deskwizard/DummyLoadV2/hardware/DummyLoadV2/Output/DummyLoadV2-analog.png

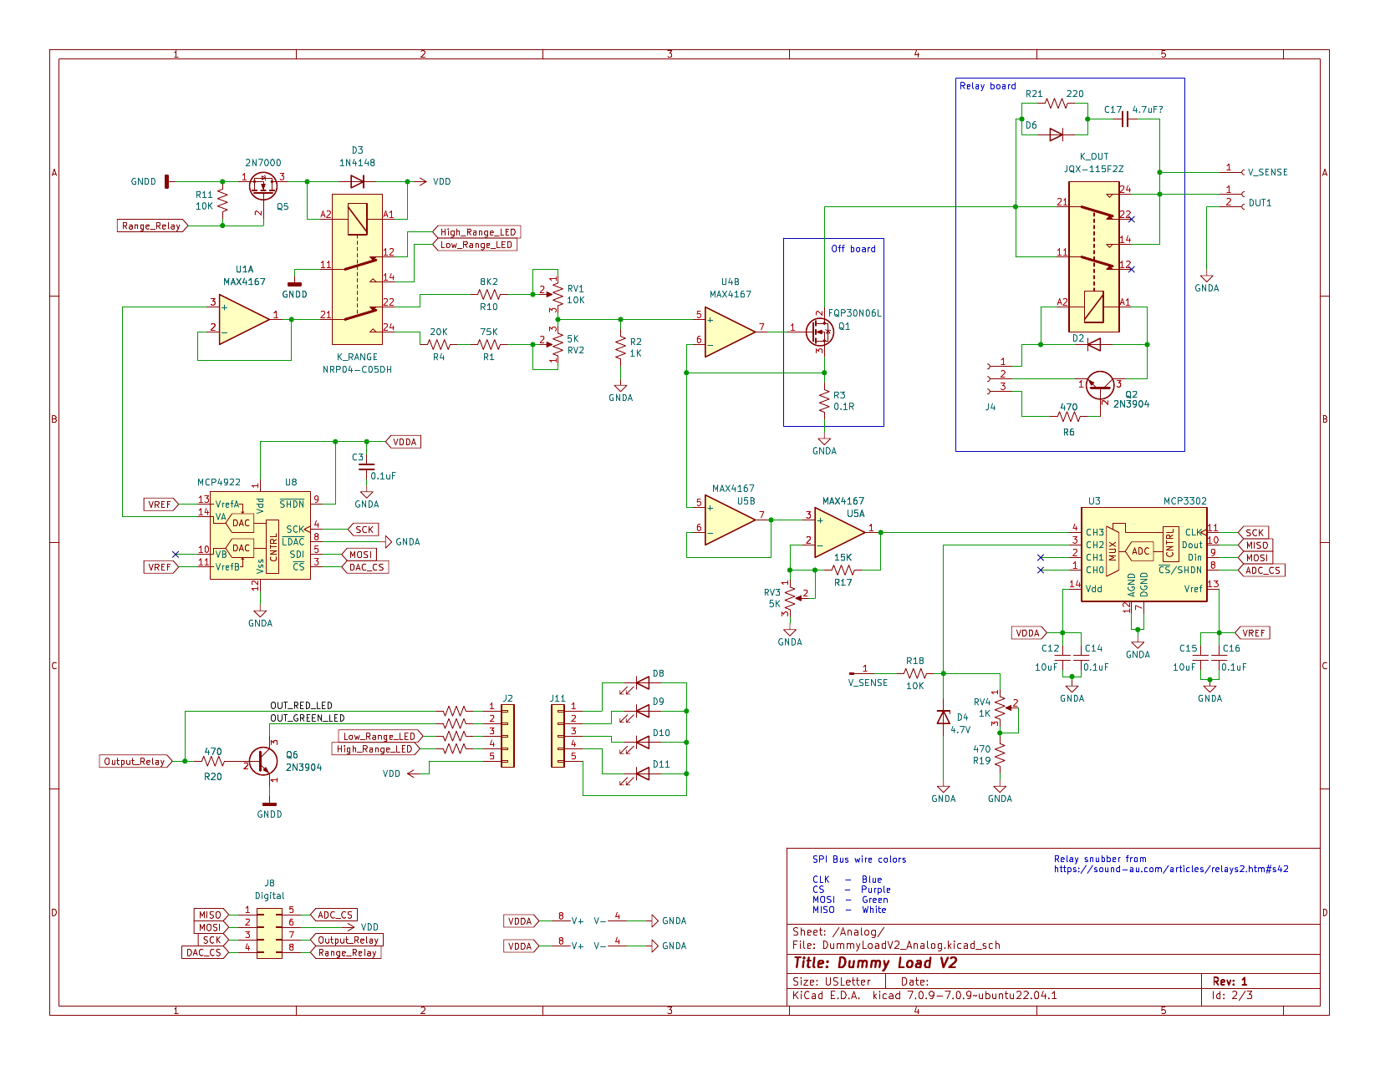
hardware/DummyLoadV2/Output/DummyLoadV2-analog.png
