deskwizard/DummyLoadV2/hardware/DummyLoadV2/Output/DummyLoadV2-digital.png

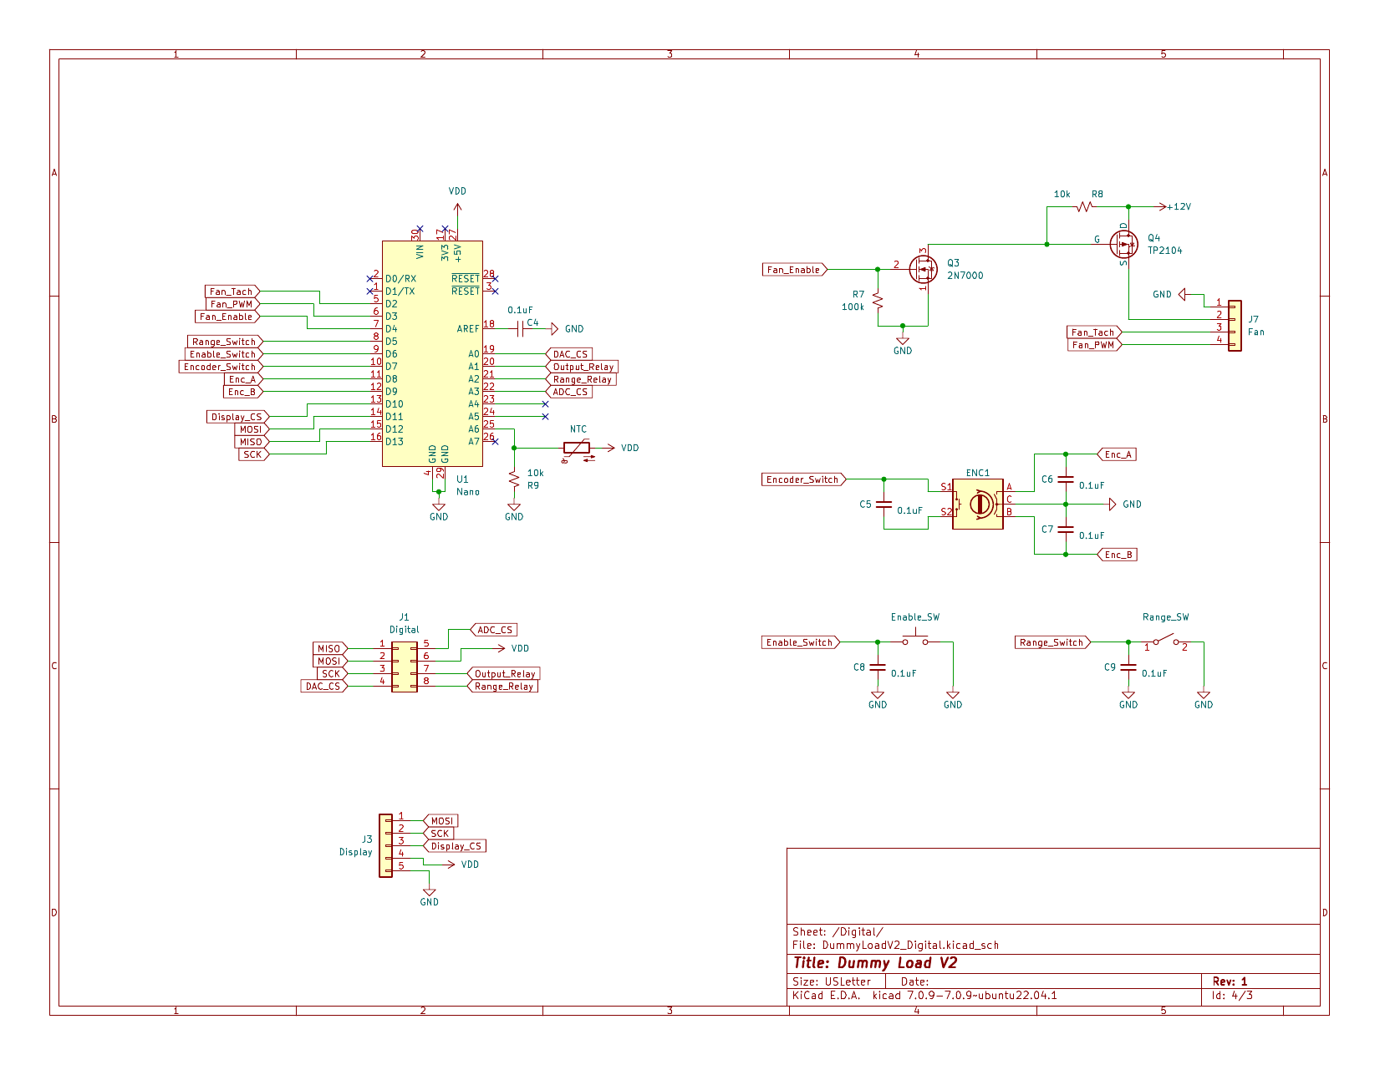
hardware/DummyLoadV2/Output/DummyLoadV2-digital.png
