deskwizard/DummyLoadV2/hardware/DummyLoadV2/Output/DummyLoadV2-main.png

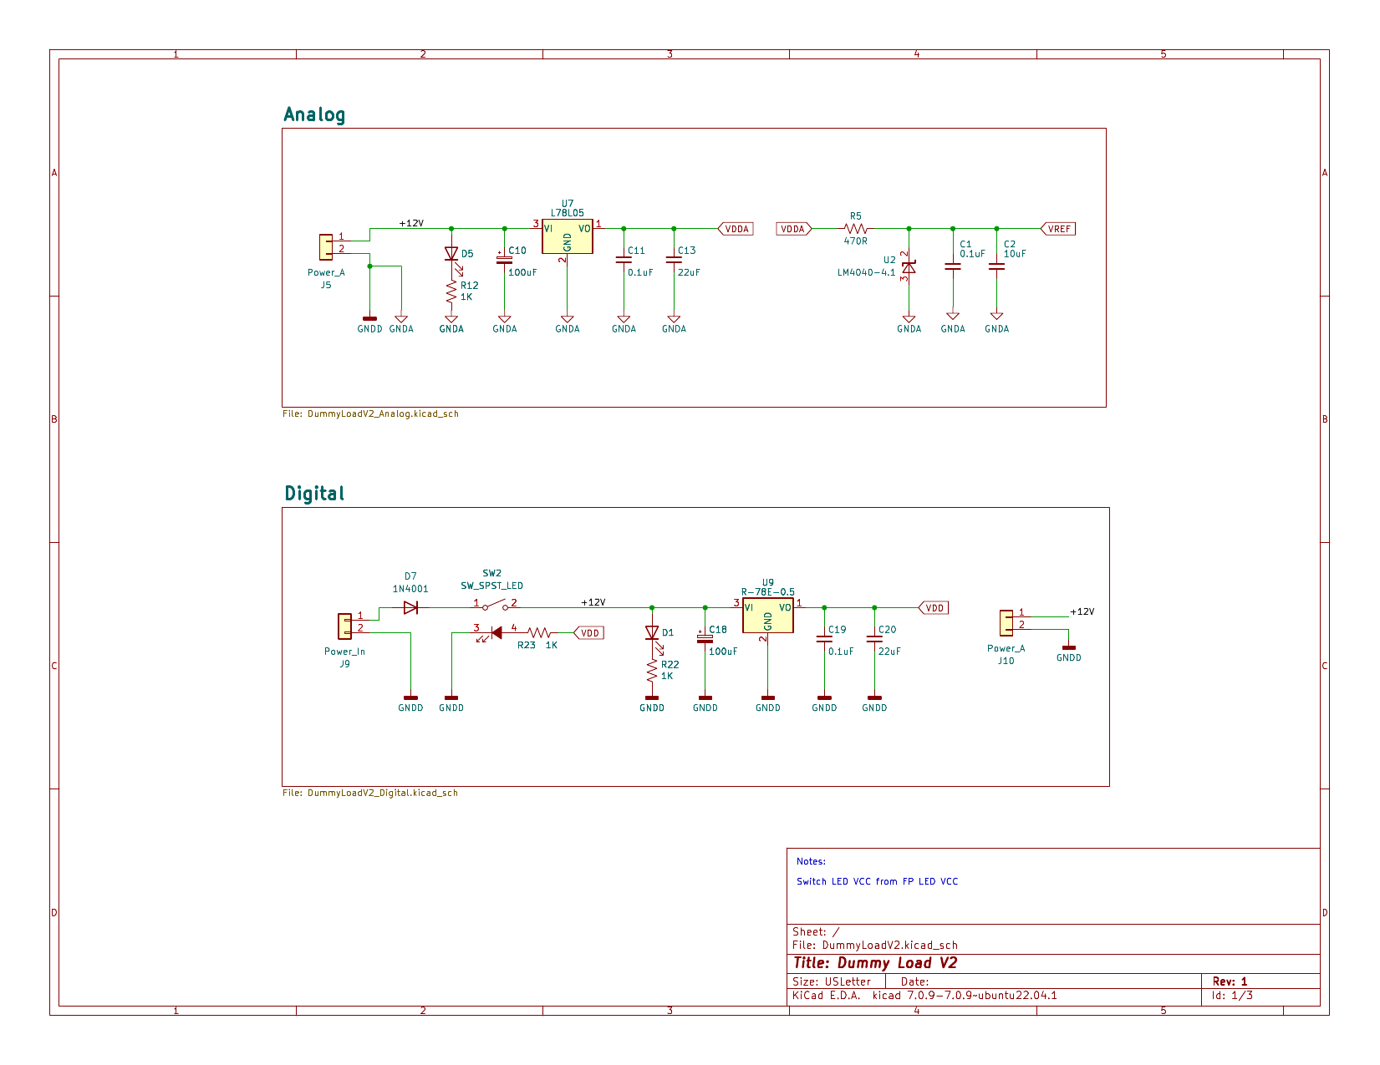
hardware/DummyLoadV2/Output/DummyLoadV2-main.png
