deskwizard/DummyLoadV2/hardware/DummyLoadV2/Output/DummyLoadV2.pdf

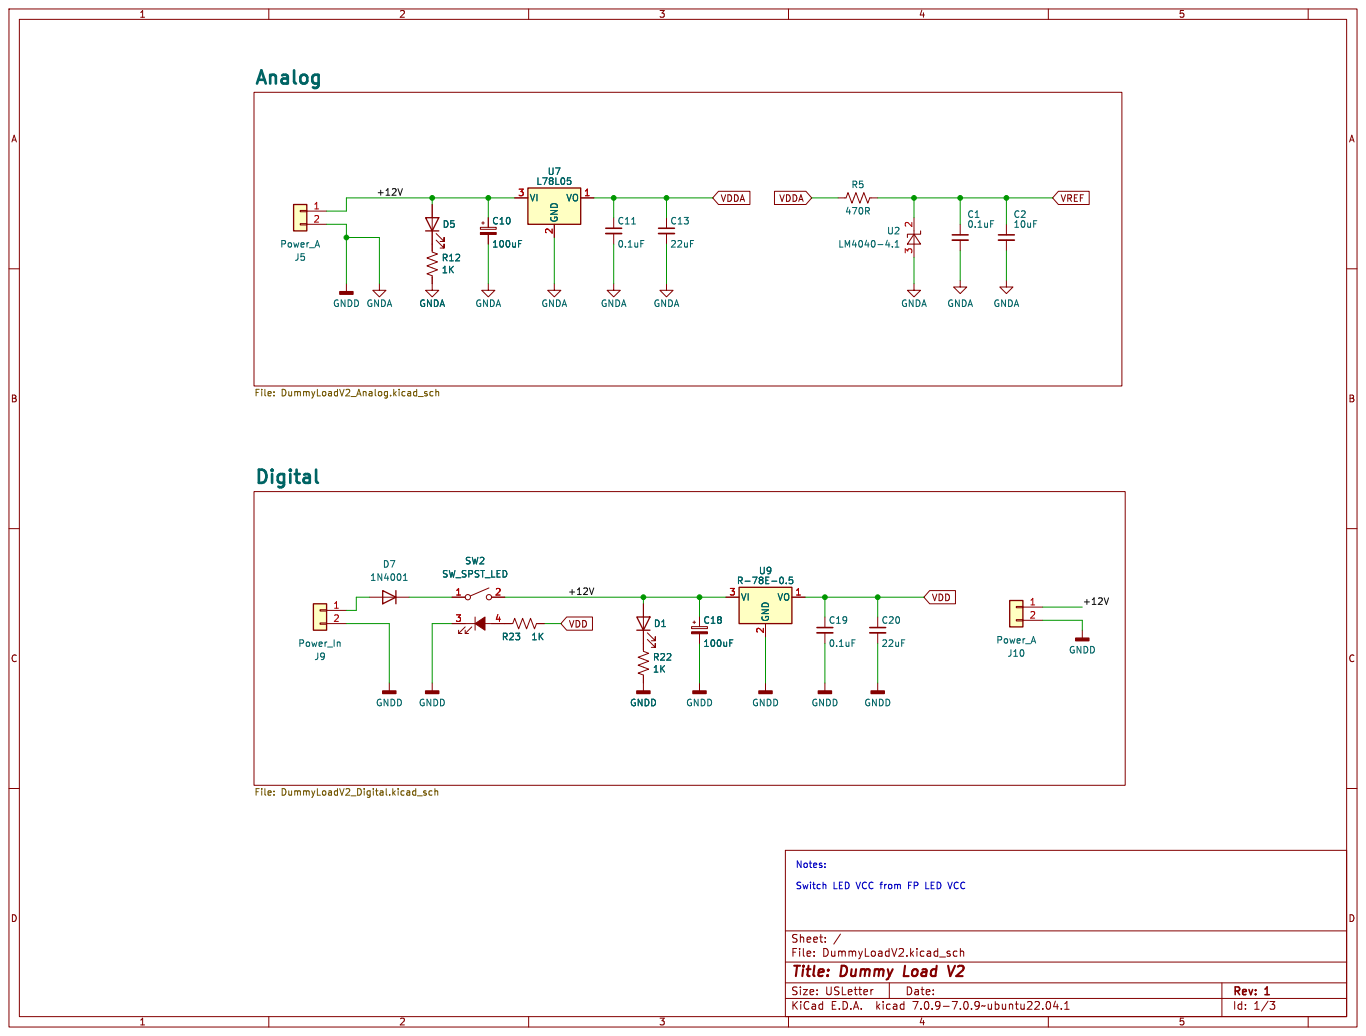
[picture p4: page 1]

+12V Notes: Switch LED VCC from FP LED VCC

Id: 1/3 Title: Dummy Load V2

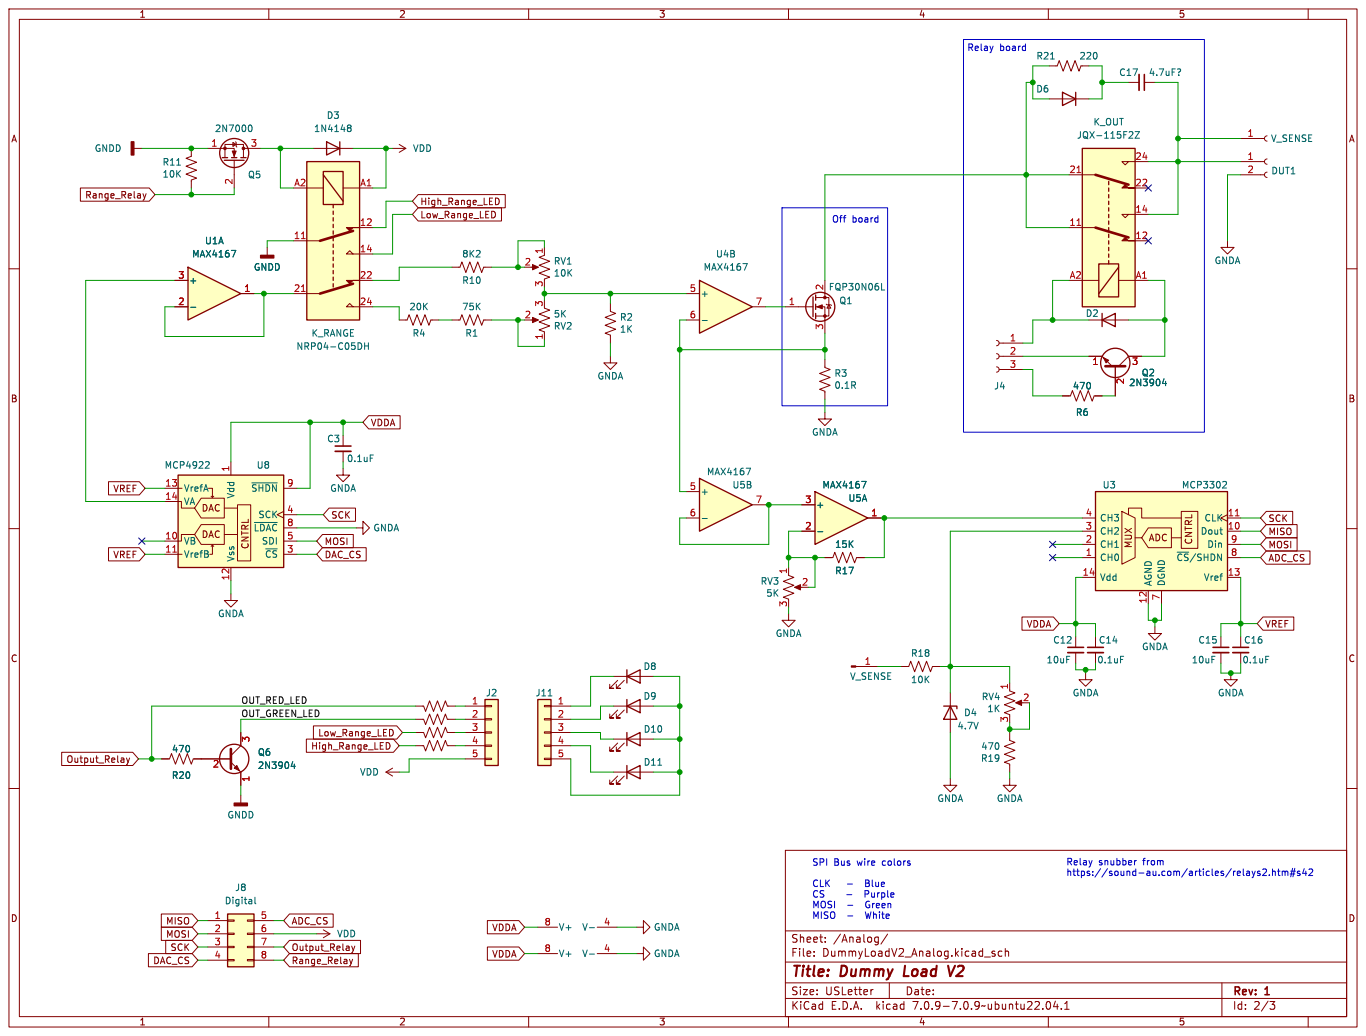
[picture p5: page 2]

1 VB 10 VrefB 11 Vss 12 VrefA 13 VA 14 ~{CS}3 SCK 4 SDI 5 ~{LDAC}8 ~{SHDN}9 MCP4922 U8 R21 220 D6

7 ~{CS}/SHDN 8 Din 9 U3 MCP3302 GNDA

Id: 2/3 Title: Dummy Load V2

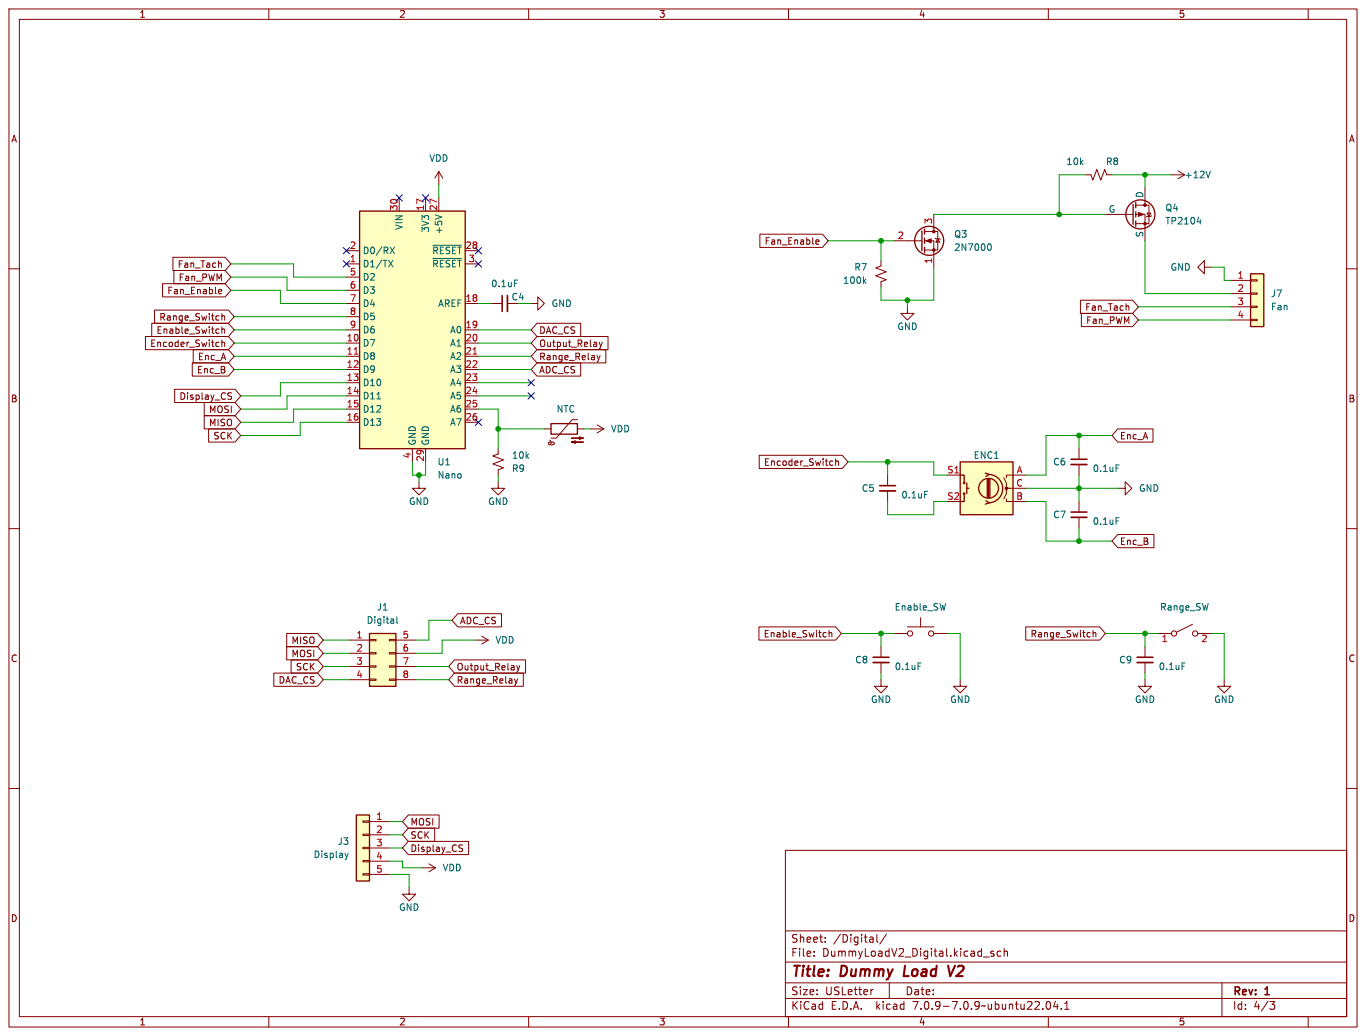
[picture p6: page 3]

File: DummyLoadV2_Digital.kicad_sch Sheet: /Digital/ GND

Id: 4/3 Title: Dummy Load V2
