deskwizard/DummyLoadV2/hardware/DummyLoadV2/DummyLoadV2.kicad_sch

## KiCad design hardware/DummyLoadV2/DummyLoadV2.kicad_sch (2023-11-14, an earlier design)

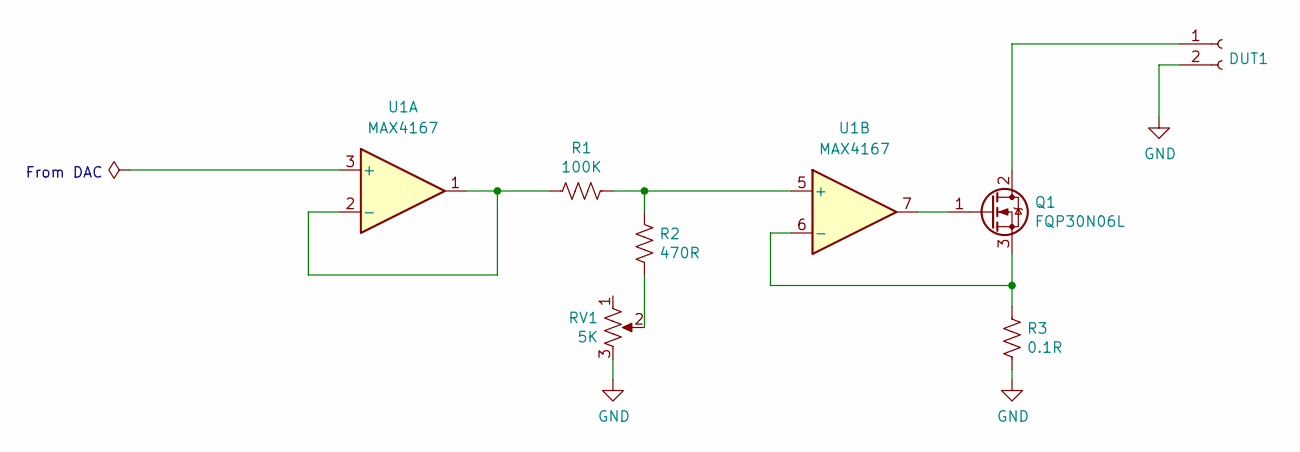
[picture p7: schematic DummyLoadV2.kicad_sch]

Parts:
DUT1: Conn_01x02_Female
Q1: FQP30N06L; TO-252-2
R1: 100K
R2: 470R
R3: 0.1R
RV1: 5K
U1: MAX4167

Connections:
GND: DUT1.2, R3.1, RV1.3
unnamed: DUT1.1, Q1.2 (D)
unnamed: Q1.1 (G), U1.7
unnamed: Q1.3 (S), R3.2, U1.6 (-)
unnamed: R1.1, R2.2, U1.5 (+)
unnamed: R1.2, U1.1, U1.2 (-)
unnamed: R2.1, RV1.2

Notes on the sheet:
From DAC
