deskwizard/DummyLoadV2/hardware/DummyLoadV2/DummyLoadV2_Analog.kicad_sch

## KiCad design hardware/DummyLoadV2/DummyLoadV2_Analog.kicad_sch (2023-11-14, an earlier design)

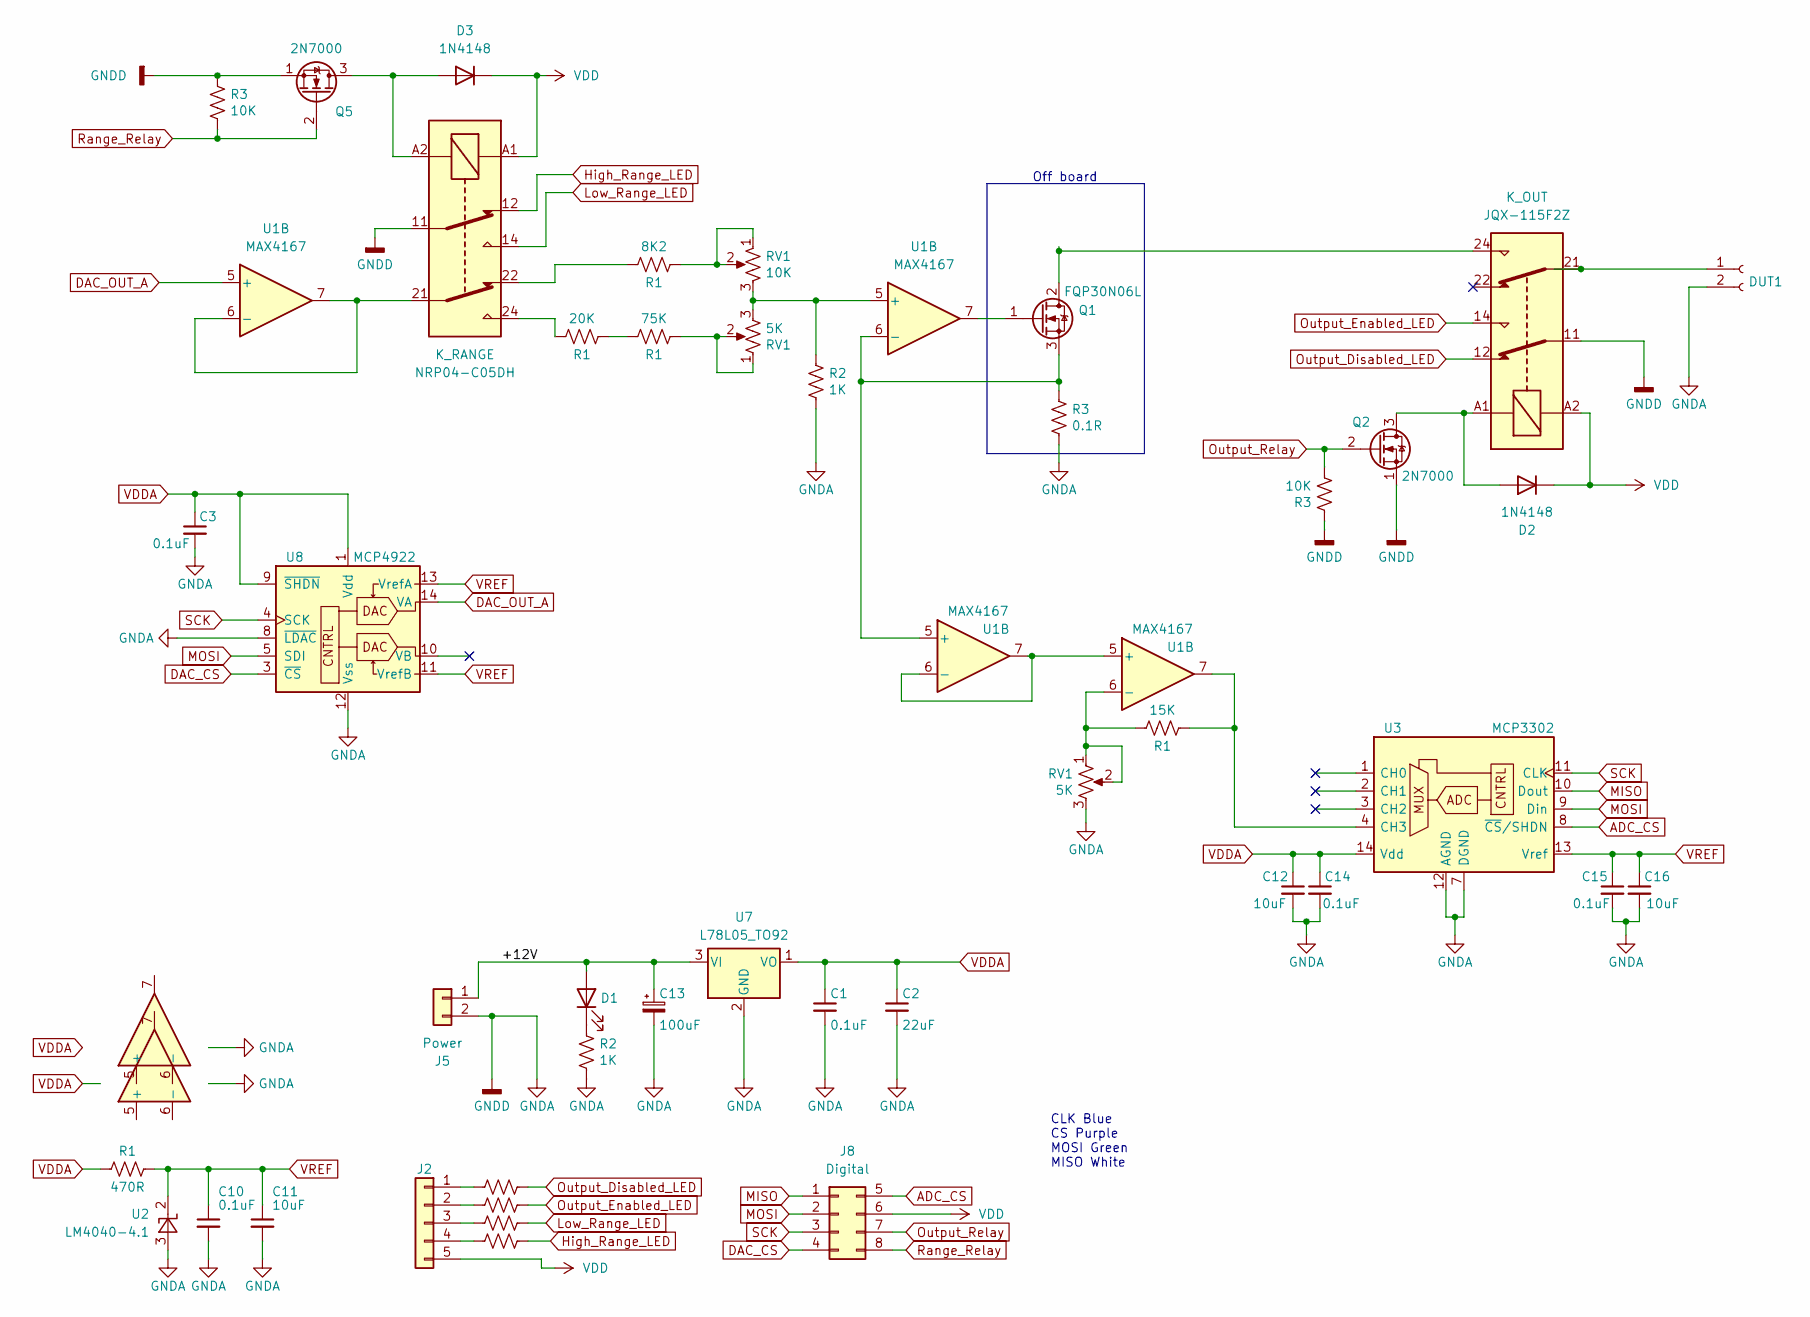
[picture p8: schematic DummyLoadV2_Analog.kicad_sch]

Parts:
C1, C3, C10, C14, C15: 0.1uF
C2: 22uF
C11, C12, C16: 10uF
C13: 100uF
D1: LED
D2, D3: 1N4148; D_DO-35_SOD27_P7.62mm_Horizontal
DUT1: Conn_01x02_Female
J2: Conn_01x05
J5: Power
J8: Digital
K_OUT: JQX-115F2Z
K_RANGE: NRP04-C05DH
Q1: FQP30N06L; TO-252-2
Q2, Q5: 2N7000; TO-92_Inline
R1: 8K2
R2: 1K
R3: 10K
RV1: 10K
U1: MAX4167
U2: LM4040-4.1; TO-92_Inline
U3: MCP3302
U7: L78L05_TO92; TO-92_Inline
U8: MCP4922

Connections:
+12V: C13.1, D1.2 (A), J5.1, U7.3 (VI)
ADC_CS: J8.5, U3.8 (~CS/SHDN)
DAC_CS: J8.4, U8.3 (~CS)
DAC_OUT_A: U1.5 (+), U8.14 (VA)
GNDA: C1.2, C2.2, C3.2, C10.2, C11.2, C12.2, C13.2, C14.2, C15.2, C16.2, DUT1.2, J5.2, K_OUT.11, K_RANGE.11, Q2.1 (S), Q5.1 (S), R2.1, R3.1, R3.2, RV1.3, U2.3 (A), U3.7 (DGND), U3.12 (AGND), U7.2 (GND), U8.8 (~LDAC), U8.12 (Vss)
High_Range_LED: K_RANGE.12, R1.1
Low_Range_LED: K_RANGE.14, R1.1
MISO: J8.1, U3.10 (Dout)
MOSI: J8.2, U3.9 (Din), U8.5 (SDI)
unnamed: D1.1 (K), R2.2
unnamed: D2.2 (A), K_OUT.A1, Q2.3 (D)
unnamed: D3.2 (A), K_RANGE.A2, Q5.3 (D)
unnamed: DUT1.1, K_OUT.21
unnamed: J2.1, R1.2
unnamed: J2.2, R1.2
unnamed: J2.3, R1.2
unnamed: J2.4, R1.2
unnamed: K_OUT.24, Q1.2 (D)
unnamed: K_RANGE.21, U1.6 (-), U1.7
unnamed: K_RANGE.22, R1.1
unnamed: K_RANGE.24, R1.2
unnamed: Q1.1 (G), U1.7
unnamed: Q1.3 (S), R3.2, U1.5 (+), U1.6 (-)
unnamed: R1.1, R1.2, RV1.1, RV1.2, U1.6 (-)
unnamed: R1.2, RV1.1, RV1.2, U1.7, U3.4 (CH3)
unnamed: R2.2, RV1.3, U1.5 (+)
unnamed: U1.5 (+), U1.6 (-), U1.7
Output_Disabled_LED: K_OUT.12, R1.1
Output_Enabled_LED: K_OUT.14, R1.1
Output_Relay: J8.7, Q2.2 (G), R3.1
Range_Relay: J8.8, Q5.2 (G), R3.1
SCK: J8.3, U3.11 (CLK), U8.4 (SCK)
VDD: D2.1 (K), D3.1 (K), J2.5, J8.6, K_OUT.A2, K_RANGE.A1
VDDA: C1.1, C2.1, C3.1, C12.1, C14.1, R1.2, U3.14 (Vdd), U7.1 (VO), U8.1 (Vdd), U8.9 (~SHDN)
VREF: C10.1, C11.1, C15.1, C16.1, R1.1, U2.2 (K), U3.13 (Vref), U8.11 (VrefB), U8.13 (VrefA)

Notes on the sheet:
Off board
CLK Blue CS Purple MOSI Green MISO White
