deskwizard/DummyLoadV2/hardware/DummyLoadV2/DummyLoadV2_Digital.kicad_sch

## KiCad design hardware/DummyLoadV2/DummyLoadV2_Digital.kicad_sch (2023-11-14, an earlier design)

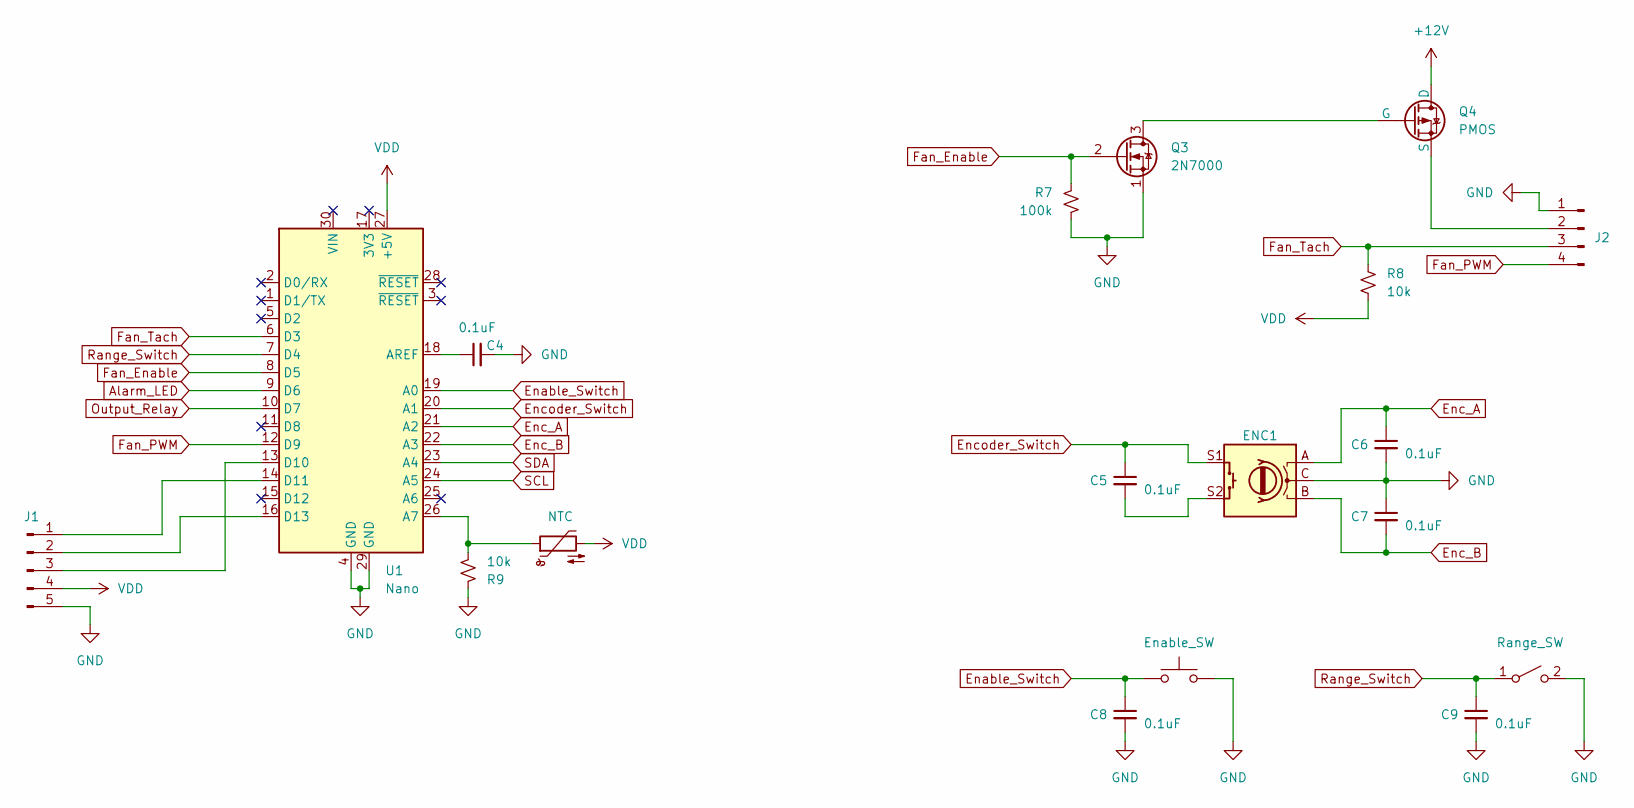
[picture p9: schematic DummyLoadV2_Digital.kicad_sch]

Parts:
C4, C5, C6, C7, C8, C9: 0.1uF
ENC1: Encoder
J1: Conn_01x05_Pin
J2: Fan
NTC: Thermistor_NTC
Q3: 2N7000; TO-92_Inline
Q4: PMOS; TO-92
R7: 100k
R8, R9: 10k
SW1: Enable_SW
SW3: Range_SW
U1: Nano; Arduino_Nano

Connections:
+12V: Q4.1 (D)
Alarm_LED: U1.9 (D6)
Enable_Switch: C8.1, SW1.1, U1.19 (A0)
Enc_A: C6.1, ENC1.A, U1.21 (A2)
Enc_B: C7.2, ENC1.B, U1.22 (A3)
Encoder_Switch: C5.1, ENC1.S1, U1.20 (A1)
Fan_Enable: Q3.2 (G), R7.1, U1.8 (D5)
Fan_PWM: J2.4, U1.12 (D9)
Fan_Tach: J2.3, R8.1, U1.6 (D3)
GND: C4.2, C6.2, C7.1, C8.2, C9.2, ENC1.C, J1.5, J2.1, Q3.1 (S), R7.2, R9.1, SW1.2, SW3.2 (B), U1.4 (GND), U1.29 (GND)
unnamed: C4.1, U1.18 (AREF)
unnamed: C5.2, ENC1.S2
unnamed: J1.1, U1.14 (D11)
unnamed: J1.2, U1.16 (D13)
unnamed: J1.3, U1.13 (D10)
unnamed: J2.2, Q4.3 (S)
unnamed: NTC.1, R9.2, U1.26 (A7)
unnamed: Q3.3 (D), Q4.2 (G)
Output_Relay: U1.10 (D7)
Range_Switch: C9.1, SW3.1 (A), U1.7 (D4)
SCL: U1.24 (A5)
SDA: U1.23 (A4)
VDD: J1.4, NTC.2, R8.2, U1.27 (+5V)
