deskwizard/DummyLoadV2/(commit log)

2023-09-02 Moved output state LED to R/G in hardware
2023-09-04 Changed pins around, couldn't get good ADC reads
2023-09-28 i²c broken on stm, moving to nano
    [control.cpp, control.h, cooling.cpp, display.cpp, input.cpp, main.cpp, pins.h]
2023-09-30 Added Kicad files
    [DummyLoadV2.kicad_pcb, DummyLoadV2.kicad_sch]
2023-09-30 Fan PWM and RPM display fixes
    [cooling.cpp, cooling.h, main.cpp]
2023-10-03 Moved pins around
    [DummyLoadV2.kicad_sch, DummyLoadV2_Digital.kicad_sch, DummyLoadV2_OutputStage.kicad_sch, DummyLoadV2_PowerSupply.kicad_sch]
2023-10-03 Removed alarm LED
2023-10-03 Fan stops at times....
2023-10-03 vref as variable
    [DummyLoadV2_OutputStage.kicad_sch]
2023-10-03 Before screwing it up
2023-10-04 - Changed fan temperature threshold - Using internal pullup for fan tach
2023-10-04 Added hardware schematic sheets
    [DummyLoadV2_Digital.kicad_sch, DummyLoadV2_OutputStage.kicad_sch]
2023-10-04 moved temperature conversion to it's own function
2023-10-04 Change thresholds to degrees instead of ADC values
2023-10-04 Updated pin mapping in schematic
    [DummyLoadV2_Digital.kicad_sch]
2023-10-04 Moved pins around for easier wiring
    [DummyLoadV2_Digital.kicad_sch]
2023-10-11 Fixup and pins changes for hardware
    [control.cpp, control.h, input.cpp, input.h, pins.h]
2023-10-11 Changed LedControl library to use hardware SPI
2023-10-11 Fix bad copy paste for range switch
    [input.cpp]
2023-10-11 Fixed ADC, Display, Inputs, range, etc...
    [control.cpp, control.h, cooling.cpp, display.cpp, main.cpp]
2023-10-11 Swapped relay datasheets
2023-10-13 Fixed display set mode timeout issue
    [display.cpp]
2023-10-18 Fixed range switching handling
    [control.cpp, control.h, display.cpp, input.cpp, main.cpp]
2023-10-19 Added ADC readback
2023-10-19 Formatting + CS pin high on begin()
2023-10-20 Updated schematic
    [DummyLoadV2.kicad_sch, DummyLoadV2_Analog.kicad_sch, DummyLoadV2_Digital.kicad_sch, DummyLoadV2_OutputStage.kicad_sch, DummyLoadV2_PowerSupply.kicad_sch]
2023-10-20 Moving timers to their own file
2023-10-20 timer stuff 2
2023-10-20 Voltage averaging
2023-10-24 Cleanup + voltage read channel change
2023-10-31 Added ADC datasheet
2023-10-31 Adding a 1ms delay before the ADC readings fixed the display instability for some reason...
    [control.cpp, display.cpp, pins.h]
2023-11-12 Additional delay "fixes" the display nonsense
    [control.cpp]
2023-11-12 Added load disabled between/before switching relay to help with contact arcing
2023-11-12 analog VS encoder fight...
2023-11-12 Current display fixed (Stop trying to be smart, it's not working out...)
    [control.cpp, control.h, display.cpp]
2023-11-12 Encoders good enough... nah.
2023-11-12 Encoder now on direct port manipulation
2023-11-12 Fixed voltage reading delay on "boot"
    [control.cpp, display.cpp, main.cpp]
